4lch/LoRaTempHum/LoRa_Sensor.kicad_pcb

## KiCad design LoRa_Sensor.kicad_pcb (2023-11-24)

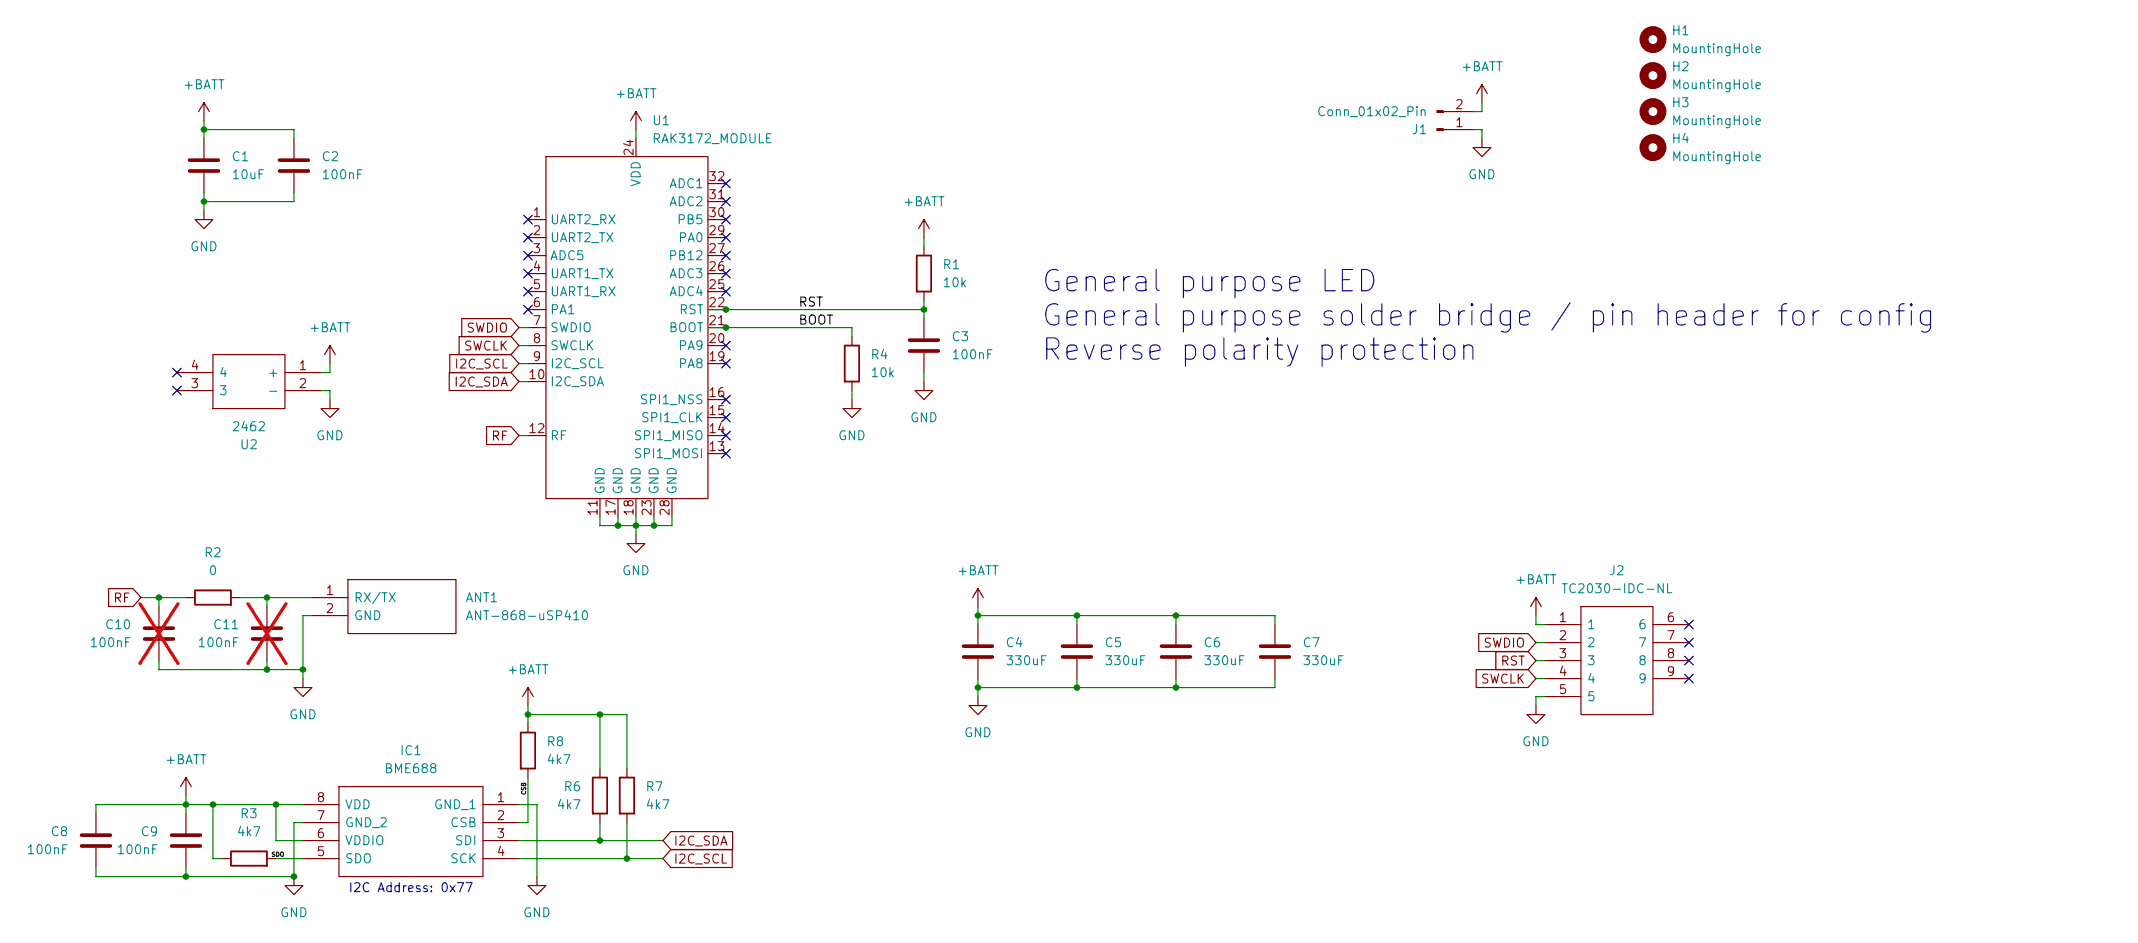
[picture p1: schematic LoRa_Sensor.kicad_sch]

Parts:
ANT1: ANT-868-uSP410; ANT868uSP410; Manufacturer_Part_Number ANT-868-uSP410; Mouser Part Number 712-ANT-868-USP410
C1: 10uF; C_0805_2012Metric
C2, C3, C8, C9: 100nF; C_0805_2012Metric
C4, C5, C6, C7: 330uF; CP_EIA-3528-15_AVX-H
C10, C11: 100nF; C_0603_1608Metric; not fitted
H1, H2, H3, H4: MountingHole; MountingHole_3.2mm_M3
IC1: BME688; Mouser Part Number 262-BME688
J1: Conn_01x02_Pin; PinHeader_1x02_P2.54mm_Vertical
J2: TC2030-IDC-NL; TC2030IDCNL; Manufacturer_Part_Number TC2030-IDC-NL
R1, R4: 10k; R_0805_2012Metric
R2: 0; R_0603_1608Metric
R3, R6, R7, R8: 4k7; R_0805_2012Metric
U1: RAK3172_MODULE
U2: 2462; Mouser Part Number 534-2462

Connections:
+BATT: C1.1, C2.1, C4.1, C5.1, C6.1, C7.1, C8.1, C9.1, IC1.6 (VDDIO), IC1.8 (VDD), J1.2, J2.1, R1.1, R3.1, R6.1, R7.1, R8.1, U1.24 (VDD), U2.1 (+)
/BOOT: R4.1, U1.21 (BOOT)
/CSB: IC1.2 (CSB), R8.2
/SDO: IC1.5 (SDO), R3.2
GND: ANT1.2 (GND), C1.2, C2.2, C3.2, C4.2, C5.2, C6.2, C7.2, C8.2, C9.2, C10.2, C11.2, IC1.1 (GND_1), IC1.7 (GND_2), J1.1, J2.5, R4.2, U1.11 (GND), U1.17 (GND), U1.18 (GND), U1.23 (GND), U1.28 (GND), U2.2 (-)
I2C_SCL: IC1.4 (SCK), R7.2, U1.9 (I2C_SCL)
I2C_SDA: IC1.3 (SDI), R6.2, U1.10 (I2C_SDA)
unnamed: ANT1.1 (RX/TX), C11.1, R2.2
RF: C10.1, R2.1, U1.12 (RF)
RST: C3.1, J2.3, R1.2, U1.22 (RST)
SWCLK: J2.4, U1.8 (SWCLK)
SWDIO: J2.2, U1.7 (SWDIO)

Notes on the sheet:
I2C Address: 0x77
General purpose LED General purpose solder bridge / pin header for config Reverse polarity protection

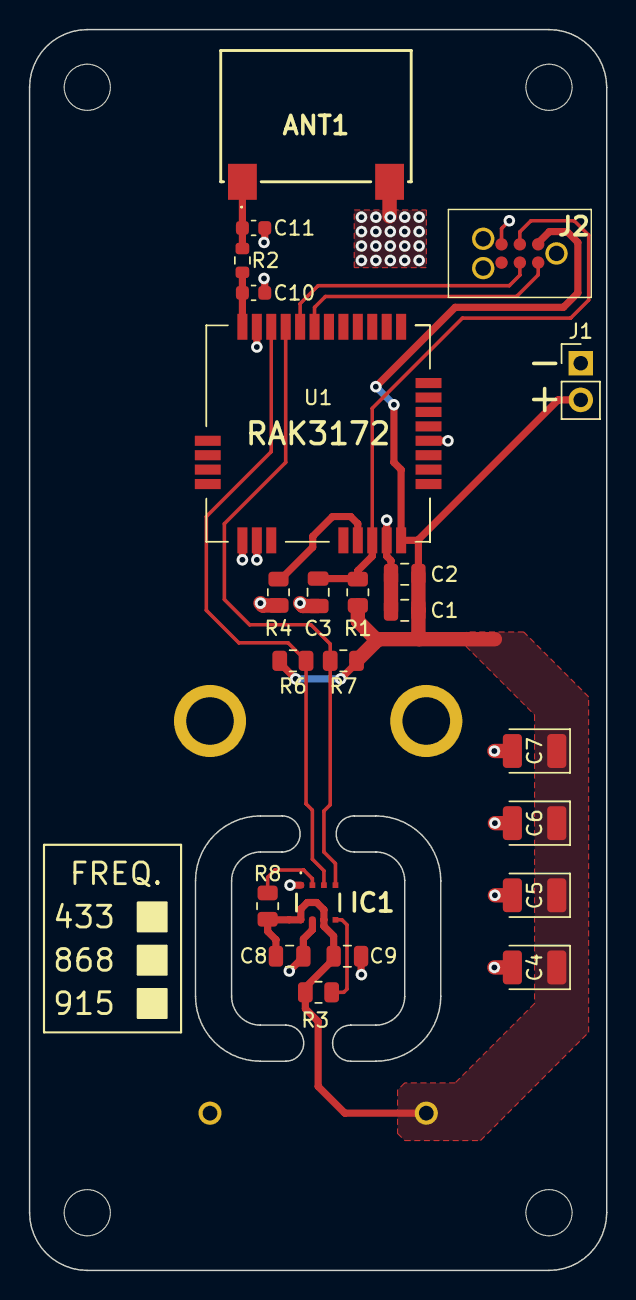
[picture p2: board LoRa_Sensor.kicad_pcb from above]

Board: 2 copper layers, 40.0 x 86.0 mm, 28 parts (1 on the bottom side), 12 nets.
