4lch/LoRaTempHum/(commit log)

2023-11-22 v0.2 en cours
    [LoRa_Sensor-B_Cu.gbr, LoRa_Sensor-B_Mask.gbr, LoRa_Sensor-B_Paste.gbr, LoRa_Sensor-B_Silkscreen.gbr, LoRa_Sensor-Edge_Cuts.gbr, LoRa_Sensor-F_Cu.gbr, LoRa_Sensor-F_Mask.gbr, LoRa_Sensor-F_Paste.gbr]
2023-11-22 done for the day :)
    [LoRa_Sensor.kicad_pcb, LoRa_Sensor.kicad_sch]
2023-11-24 add checkboxes for frequency
    [LoRa_Sensor.kicad_pcb]
